quantenlabor/hass-led-panel/Icon template (sample).docx

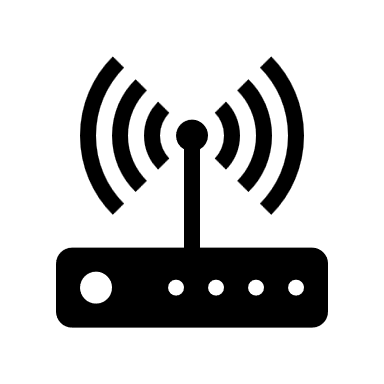
[picture p5: figure]
Wireless router with solid fill
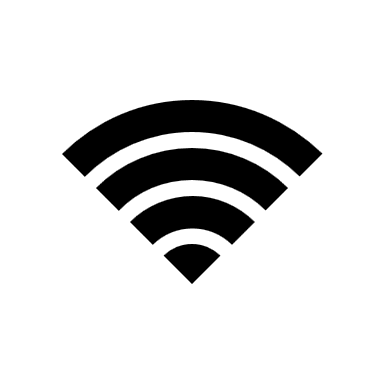
[picture p6: figure]
Wi-Fi with solid fill

| | | Home router | | | | | | WiFi

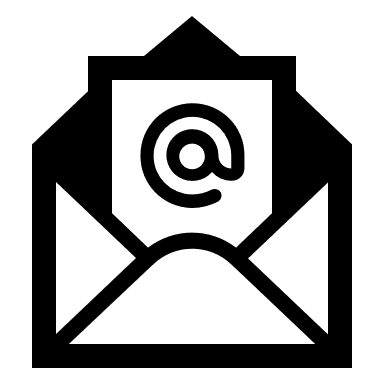
[picture p7: figure]
Email with solid fill

| | | Homeserver | | | | | | Mail server SMTP (25)

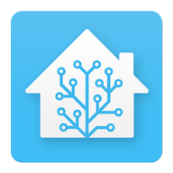
[picture p8: figure]

| | | Home Asssistant | | | | | | Mail server IMAPS (993)

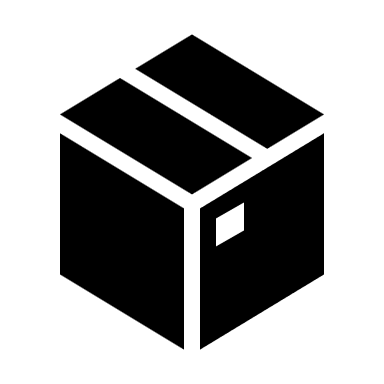
[picture p9: figure]
Box with solid fill
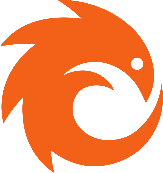
[picture p10: figure]

| | | Parcel/Post | | | | | | Pangolin (443)

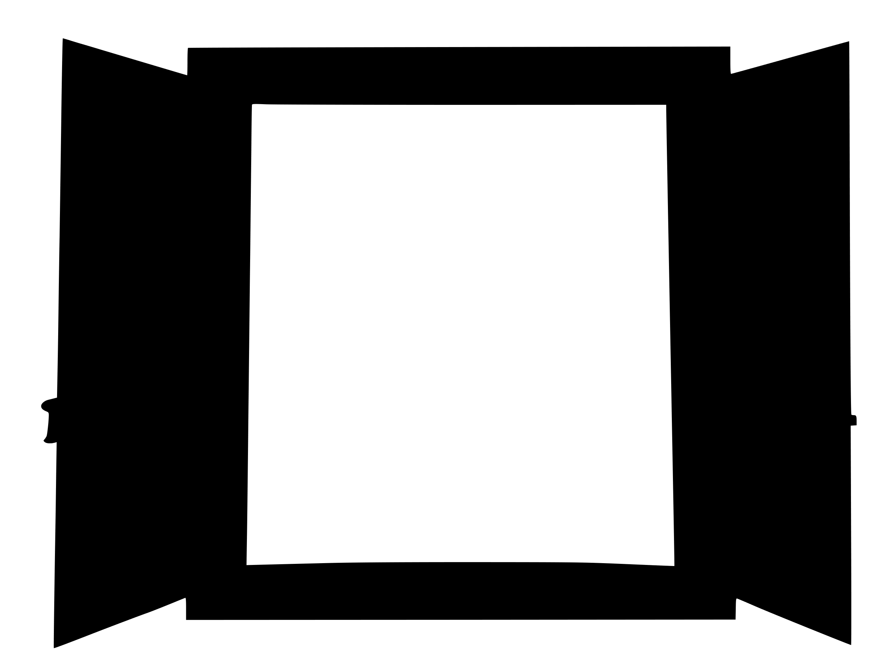
[picture p11: figure]

| | | Window open | | | | | | Nextcloud (443)
