quantenlabor/hass-led-panel/images/front with frame.JPG

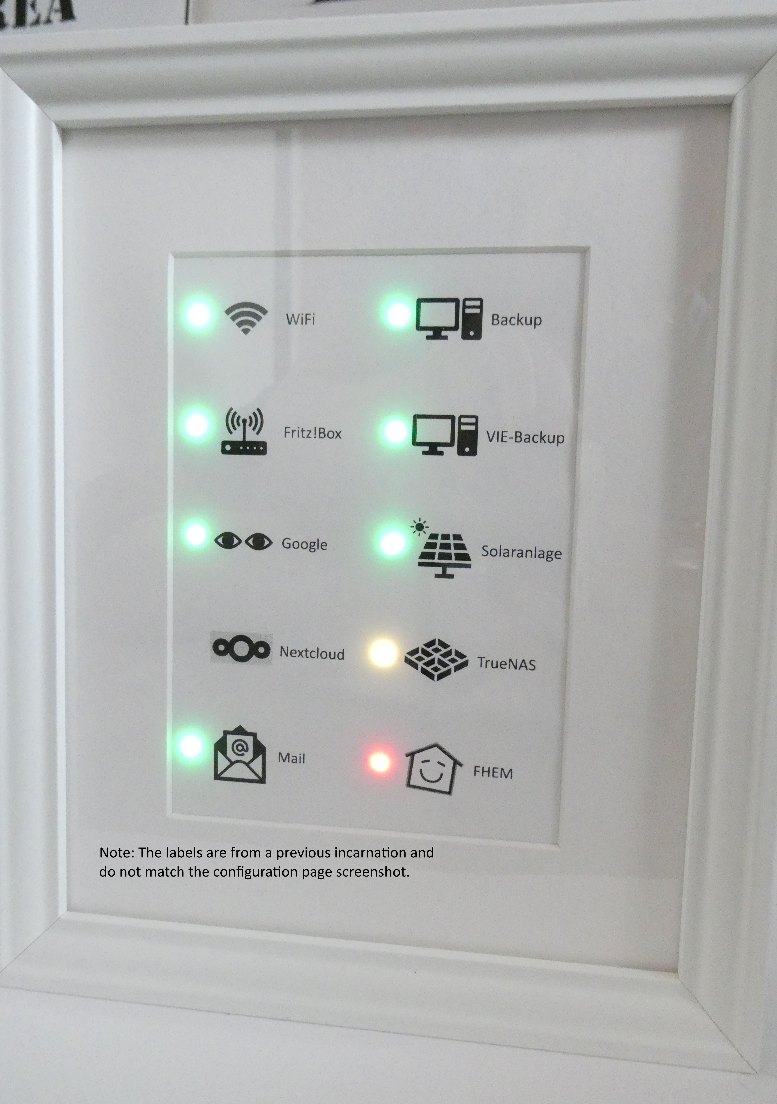
images/front with frame.JPG
